emilerenaud/Nema17_controller/README.md

# Nema17_controller
Custom PCB to control NEMA17 Stepper motor. Based on ESP32-C3 and your favorite stepper driver
