emilerenaud/Nema17_controller/Electronic/Project Outputs for NEMA17_controller/PDF/top_paste_esp.pdf

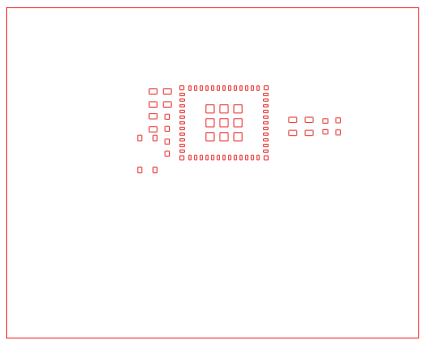
[picture p1: figure]
