emilerenaud/Nema17_controller/Mechanical/Magnet_holder.SLDPRT

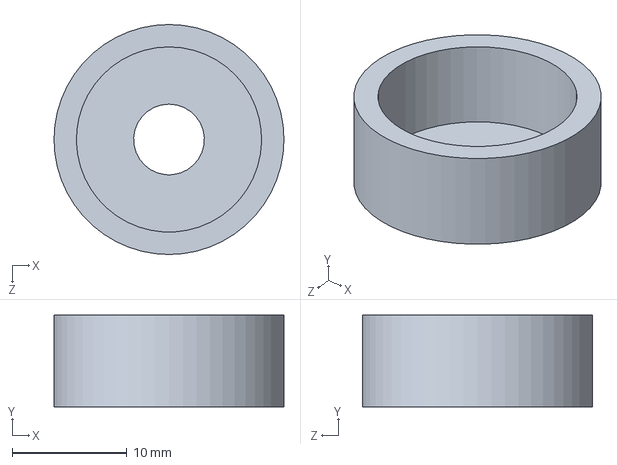
[picture p2: CAD file, 2023-07-05]
Mechanical/Magnet_holder.SLDPRT
20.0 x 8.00 x 20.0 mm
