emilerenaud/Nema17_controller/(list of files, cad)

Other CAD files:
Electronic/Project Outputs for NEMA17_controller/DXF/Top_paste.DXF
Mechanical/_STL/Magnet_holder.STL
