emilerenaud/Nema17_controller/Electronic/PCB1.pdf

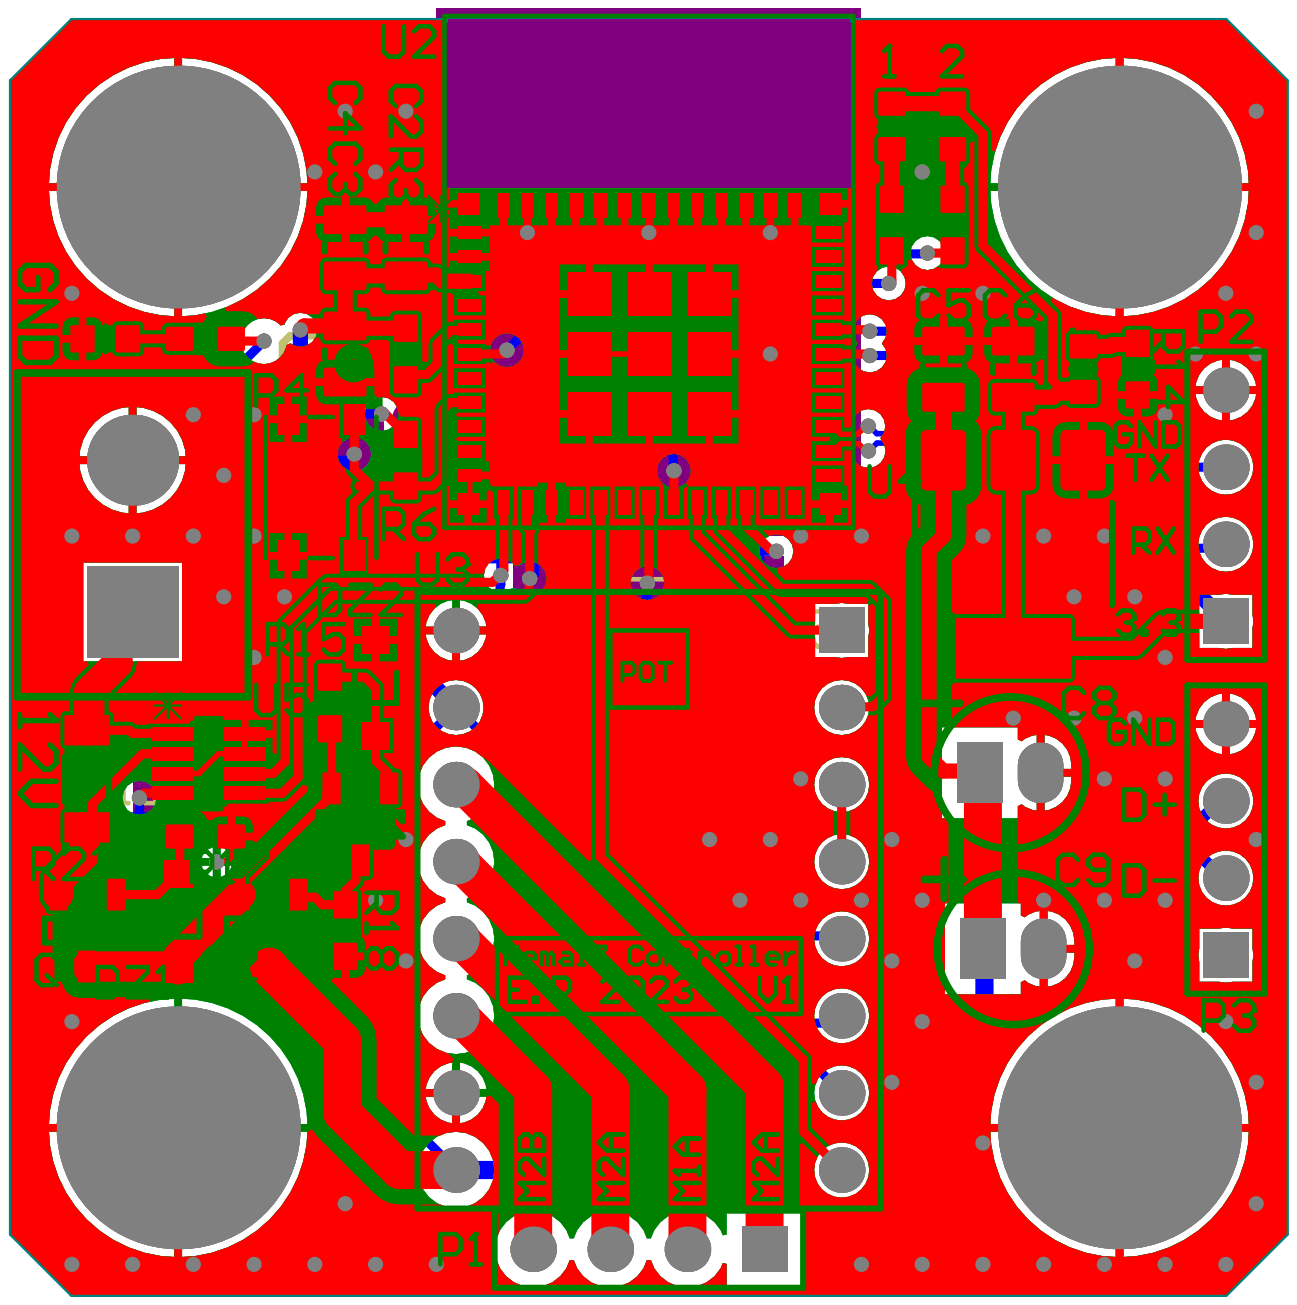
[picture p3: page 1]
