emilerenaud/Nema17_controller/Electronic/Project Outputs for NEMA17_controller/PDF/top_paste.pdf

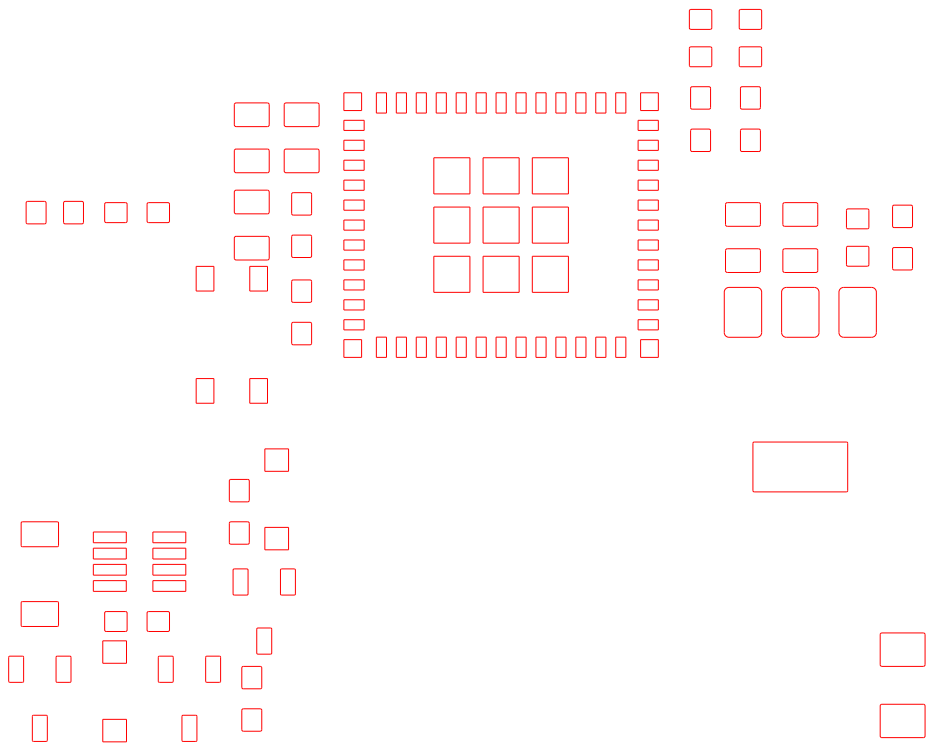
[picture p4: page 1]
