emilerenaud/Nema17_controller/Electronic/Project Outputs for NEMA17_controller/PDF/Schematic Prints.PDF

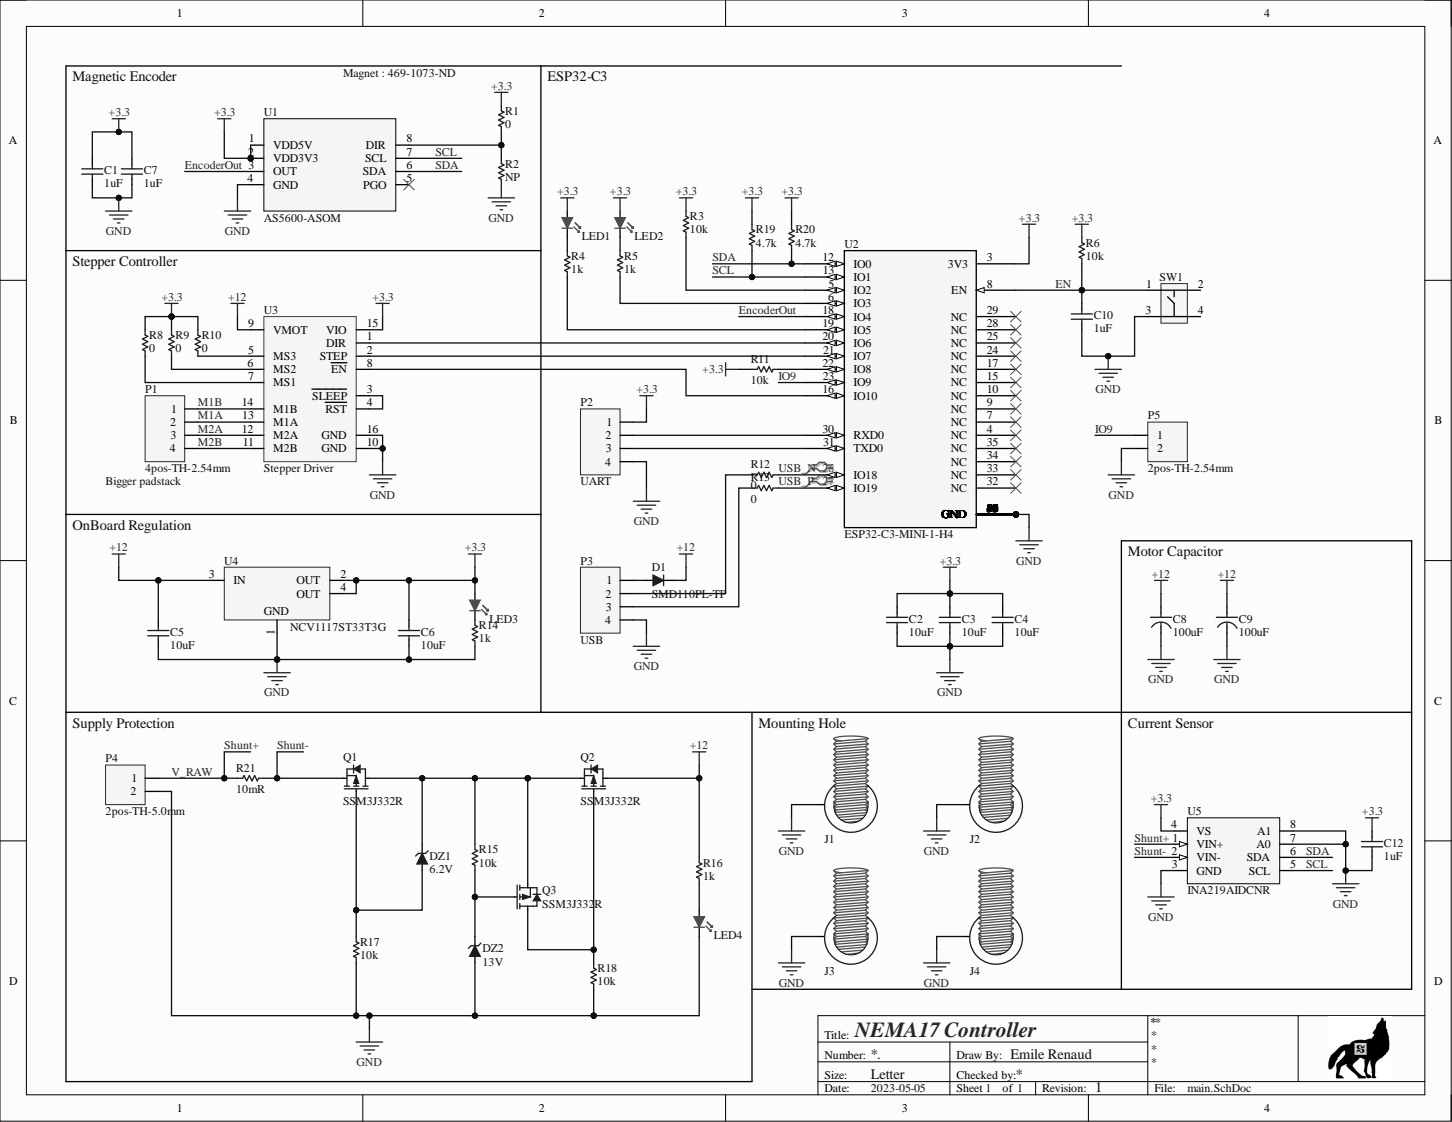
[picture p5: page 1]
