emilerenaud/Nema17_controller/(list of files, drawings)

Other design files:
Electronic/main.SchDoc
Electronic/NEMA17_controller.PrjPcb
Electronic/PCB1.PcbDoc
