emilerenaud/Nema17_controller/Software/nema17_controller/include/PCB_config.h

#ifndef _PIN_H_
#define _PIN_H_

// pin definitions for the PCB
// Led pins
#define LED_1 3
#define LED_2 5

// Position encoder AS5600-ASOM
#define ENCODER_OUT ADC1_CHANNEL_4

// Stepper pins A4899 driver
#define STEP_PIN 7
#define DIR_PIN 6
#define EN_PIN 10


// I2C bus
#define SDA_PIN 0
#define SCL_PIN 1


#endif
