emilerenaud/Nema17_controller/(commit log)

2023-03-28 base project
    [NEMA17_controller.PrjPcb, PCB1.PcbDoc, main.SchDoc]
2023-03-29 Schematic done + start pcb
    [NEMA17_controller.PrjPcb, PCB1.PcbDoc, main.SchDoc]
2023-04-20 update PCB
    [NEMA17_controller.PrjPcb, PCB1.PcbDoc, main.SchDoc]
2023-04-20 real BOM
    [NEMA17_controller_BOM.xls]
2023-04-20 PDF shit
    [Top_paste.DXF]
2023-04-20 update comment for shunt resistor
2023-04-20 get encoder working
2023-04-21 add AccelStepper lib
    [main.SchDoc]
2023-04-29 create controller class. make motor move with Serial step command
2023-05-06 revision V1.1 + gerber
    [NEMA17_controller.PrjPcb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]
2023-06-27 paste for lasercut
    [Top_paste.DXF]
2023-07-05 update code, schematic note, STL for magnet
    [Magnet_holder.SLDPRT, Magnet_holder.STL, main.SchDoc]
